Pakleni/kingslayer-28-custom-gaming-keypad/README.md

# Kingslayer 28
*Fully custom 28 key gaming keypad*

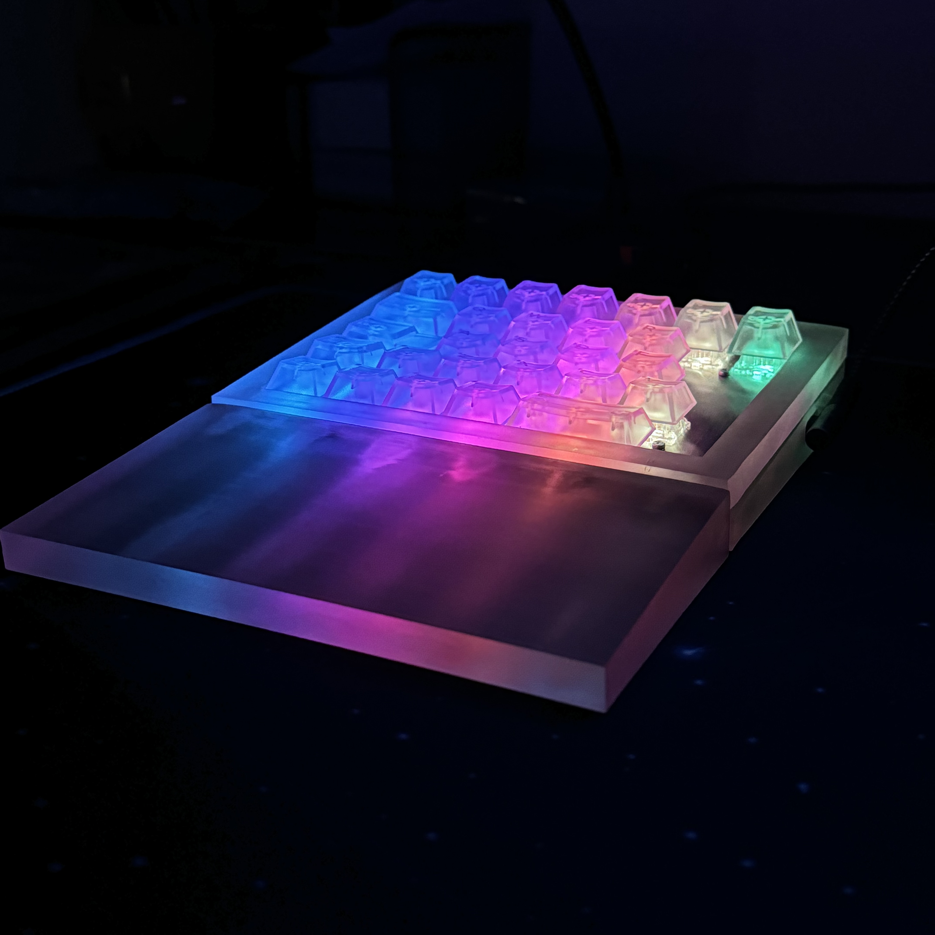
[picture p1: keyboard.jpeg]


## Images

### Keyboard Layout
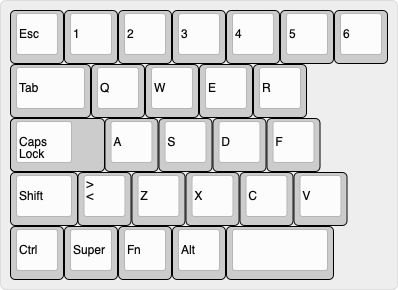
[picture p2: keyboard-layout-editor/keyboard-layout.png]


### Plate
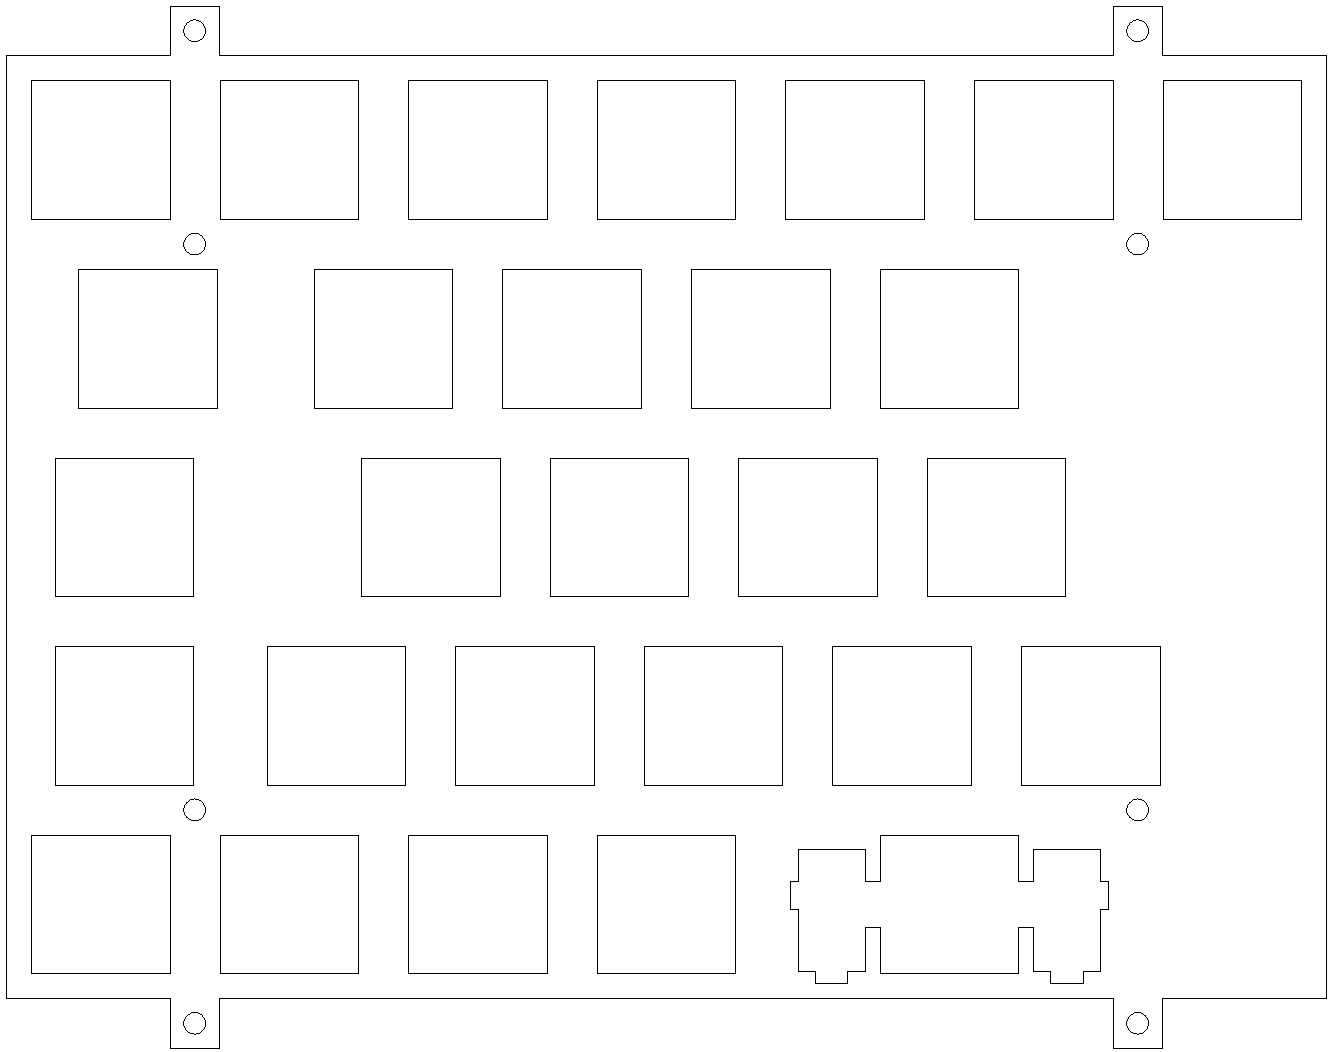
[picture p3: librecad/plate.png]


### PCB
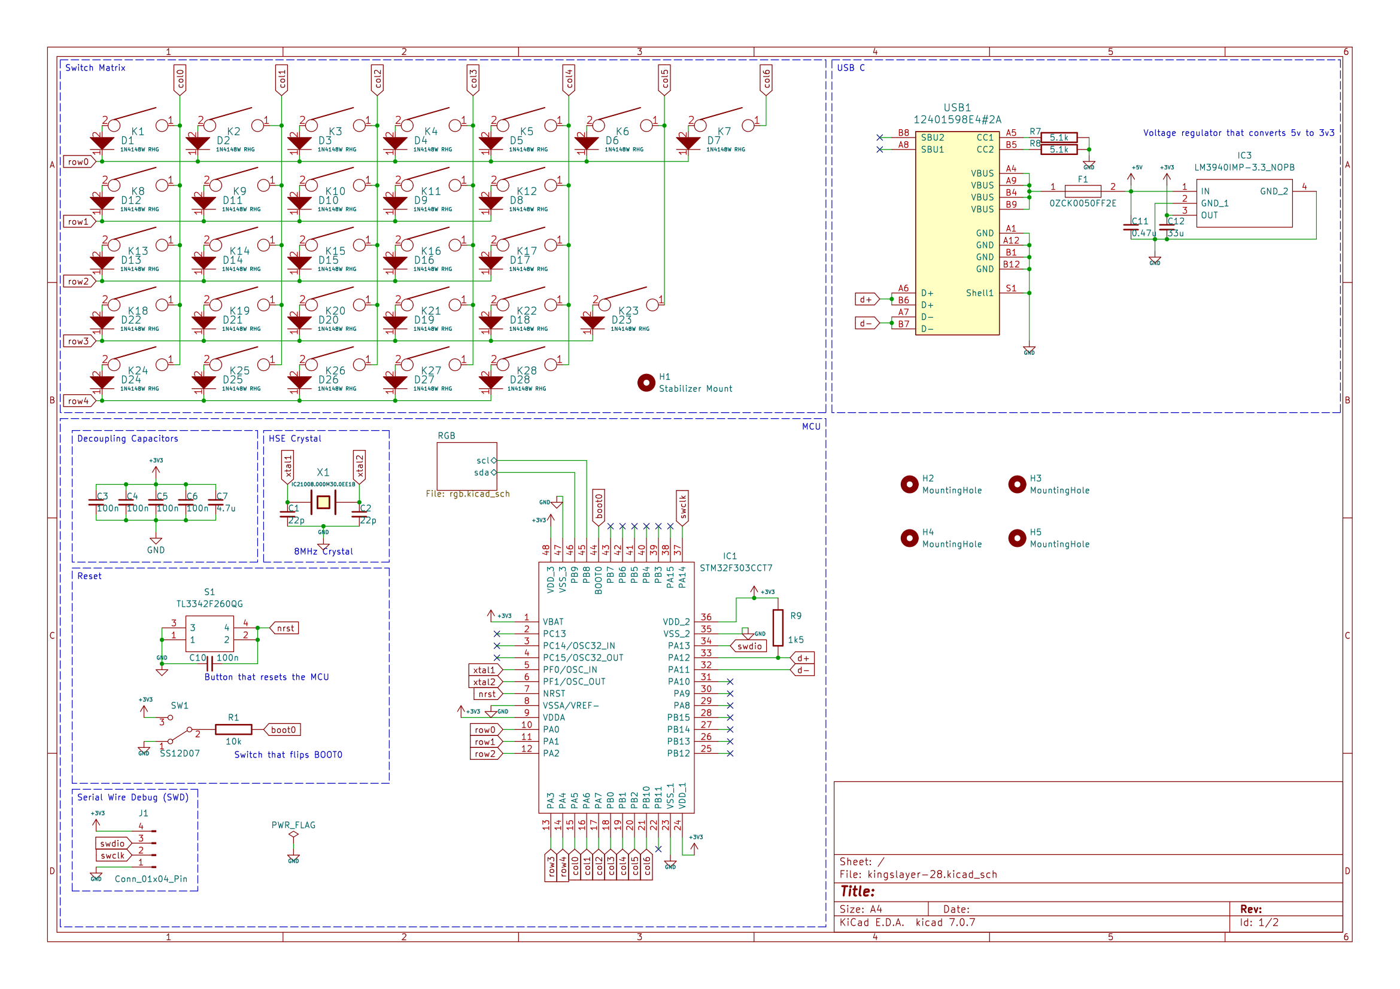
[picture p4: kicad/kingslayer-28-1.png]

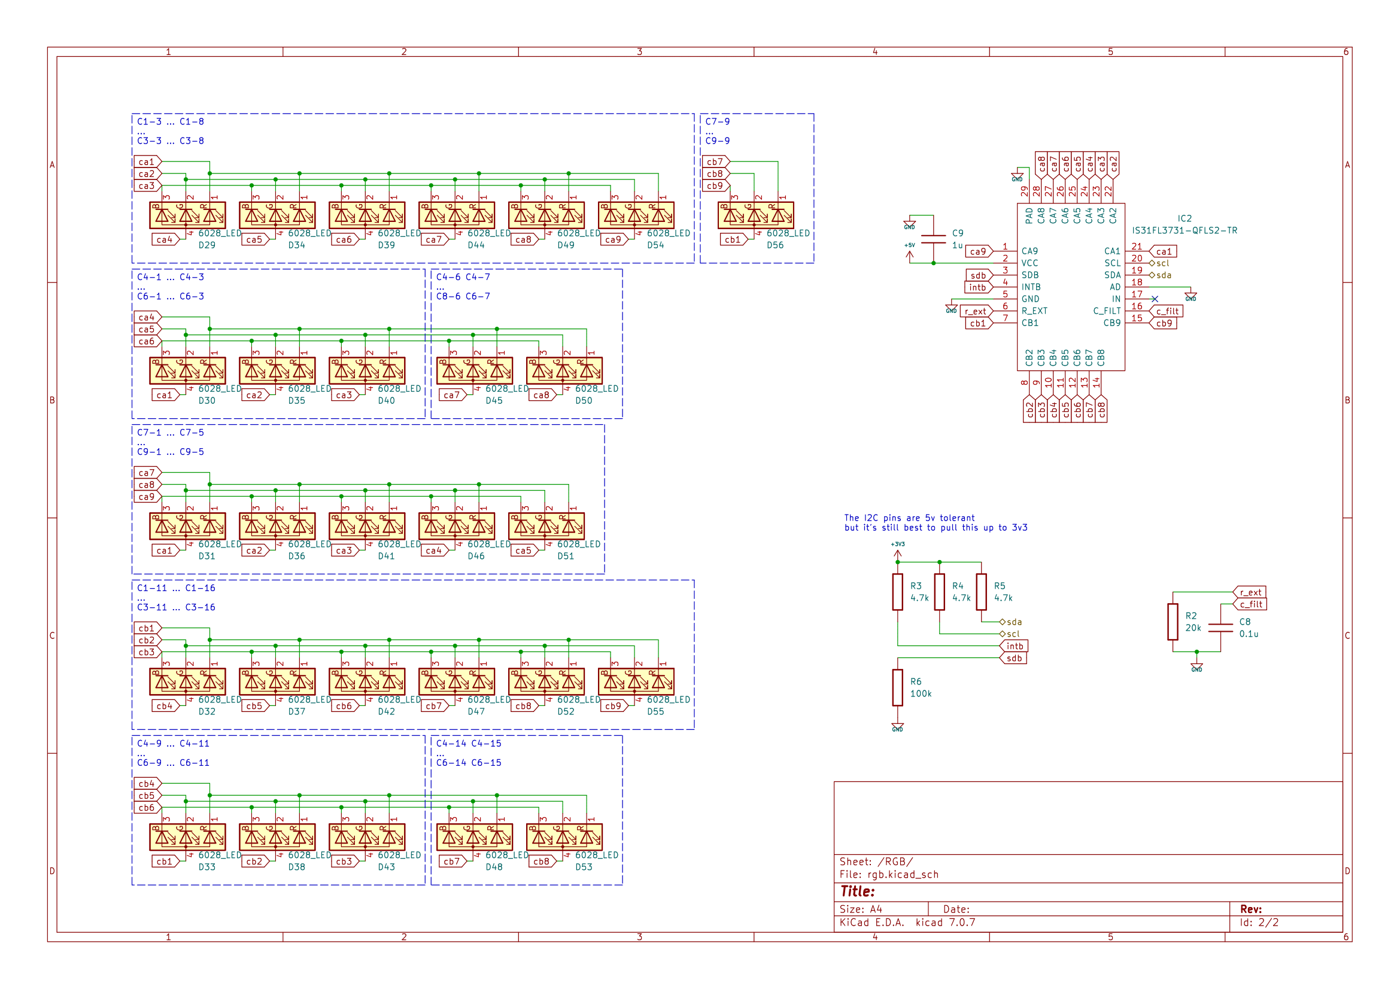
[picture p5: kicad/kingslayer-28-2.png]

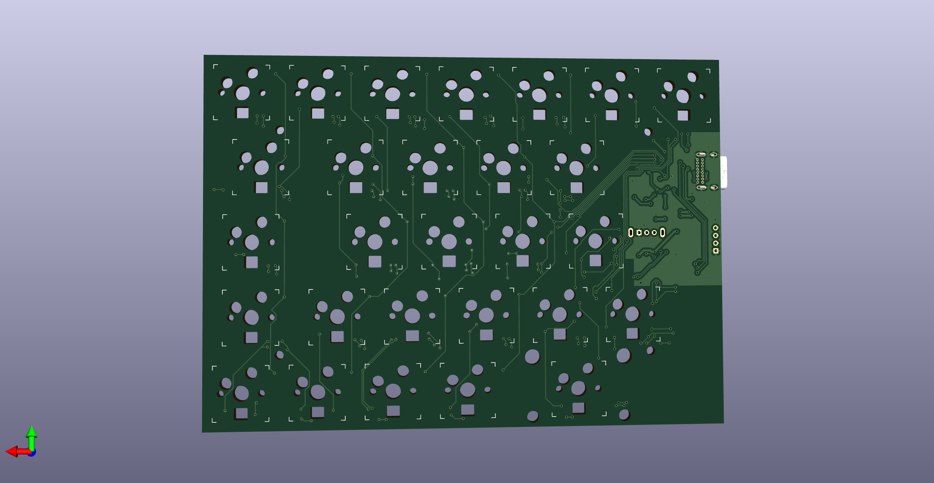
[picture p6: kicad/kingslayer-28-front.png]

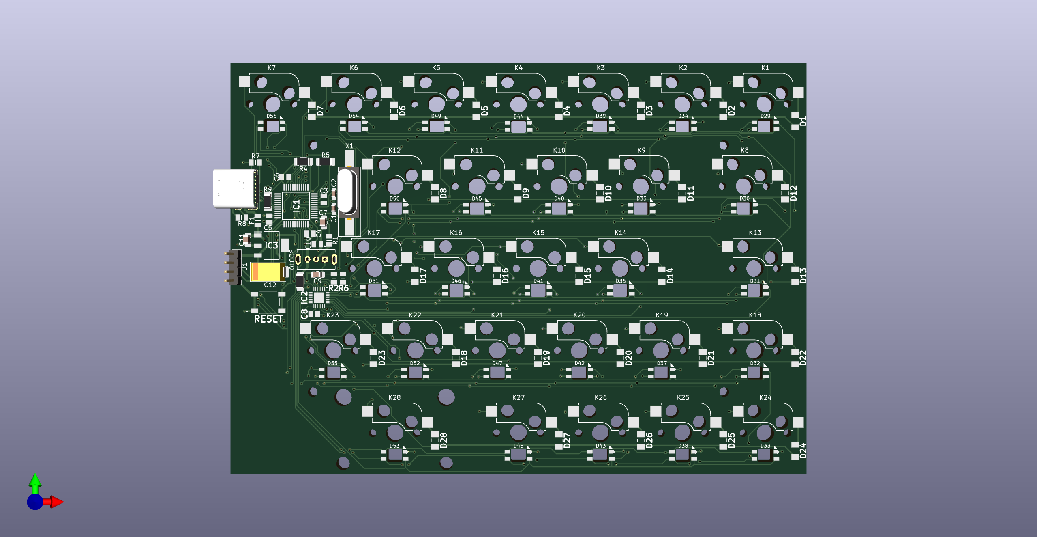
[picture p7: kicad/kingslayer-28-back.png]


## Features
* Per-Key RGB
* South Facing LED
* Hot-Swap Sockets
* Custom Plate
* USB-C
* 5-pin Sockets
* Plate Mount & PCB Screw-in Stabilizer support
* Top mount design
* QMK support
* Wrist Rest with magnetic attachment mechanism
* 5 degree positive tilt

## Used
* http://www.keyboard-layout-editor.com
* http://builder.swillkb.com
* https://librecad.org
* https://www.kicad.org
