Pakleni/kingslayer-28-custom-gaming-keypad/3dprinting/README.md

# Printing & Assembly Notes
* The .stl files are in cm, so you need to 10x them if printer reads it as mm.
* The BOOT switch stem will probably need trimming in order for everything to fit.
