Pakleni/kingslayer-28-custom-gaming-keypad/plate-drawing.jpg

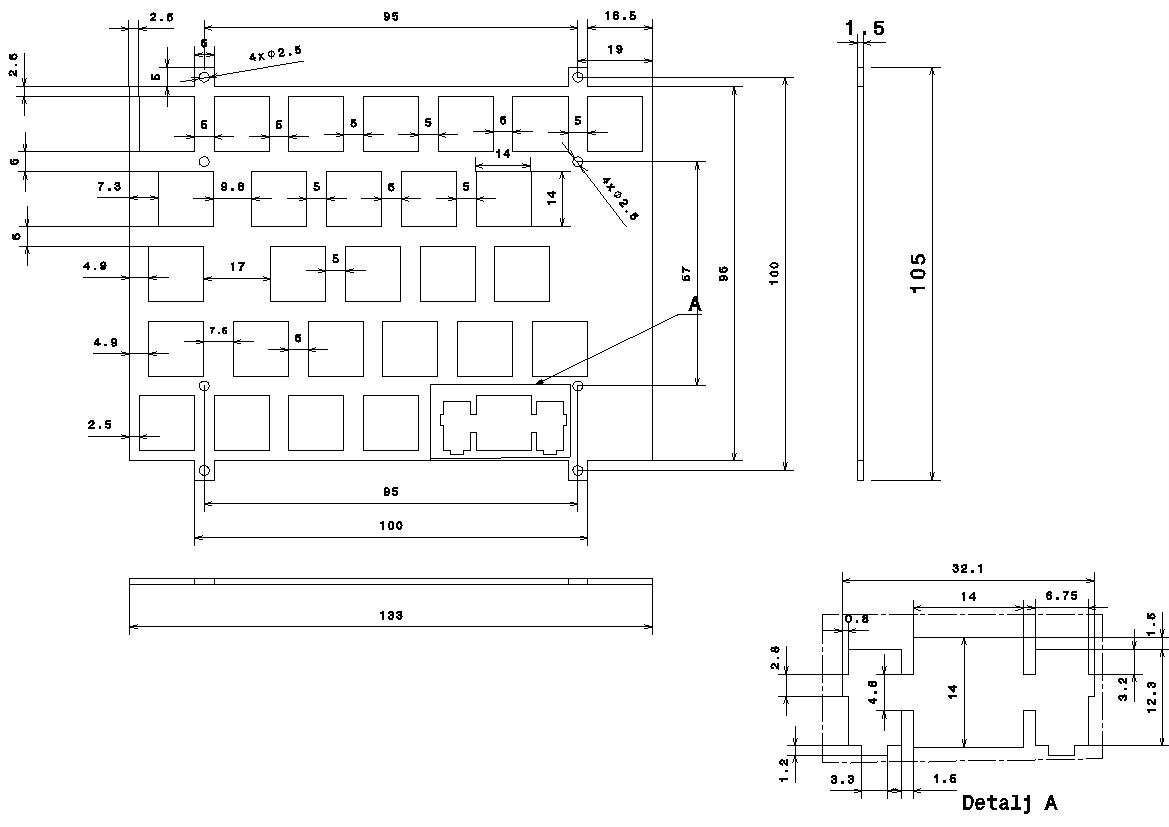
plate-drawing.jpg
