Pakleni/kingslayer-28-custom-gaming-keypad/3dprinting/spacer.stl

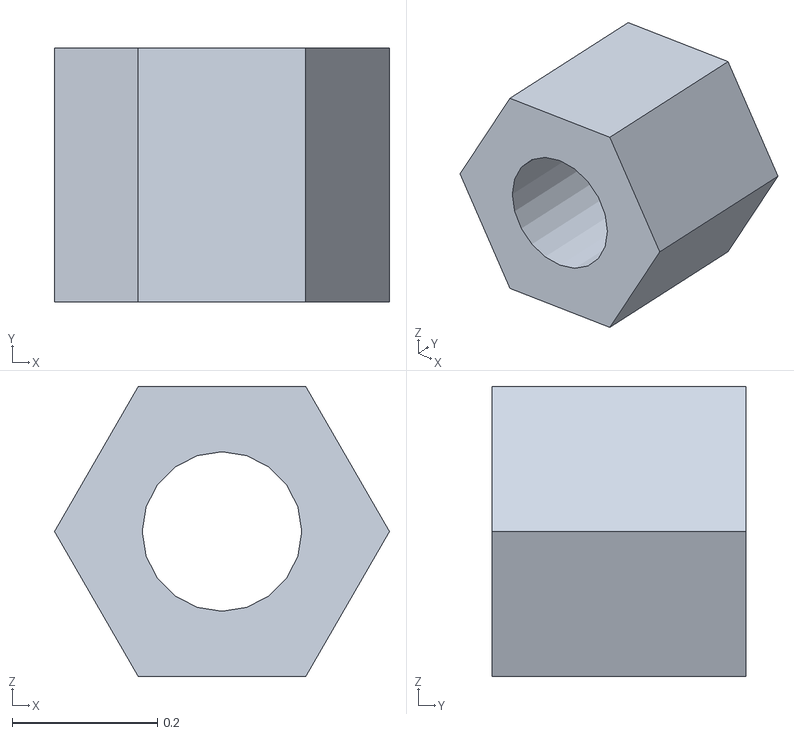
[picture p9: CAD file, 2024-06-16]
3dprinting/spacer.stl
0.462 x 0.35 x 0.4
