Pakleni/kingslayer-28-custom-gaming-keypad/kicad/kingslayer-28/3dmodels/0ZCK0050FF2E.stp

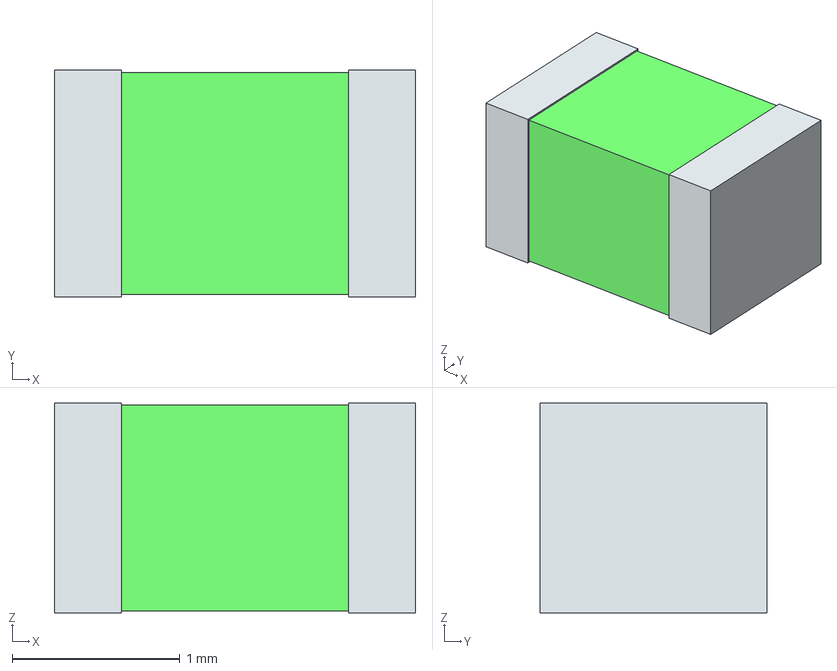
[picture p10: CAD file, 2023-10-20]
kicad/kingslayer-28/3dmodels/0ZCK0050FF2E.stp
2.15 x 1.35 x 1.25 mm
term1
term2
