Pakleni/kingslayer-28-custom-gaming-keypad/librecad/plate.dxf

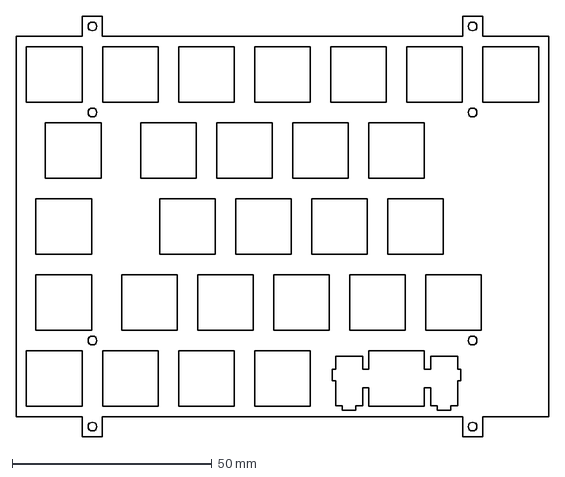
[picture p11: CAD file, 2023-09-16]
librecad/plate.dxf
133.3 x 105.2 mm
