Pakleni/kingslayer-28-custom-gaming-keypad/3dprinting/case-top.stl

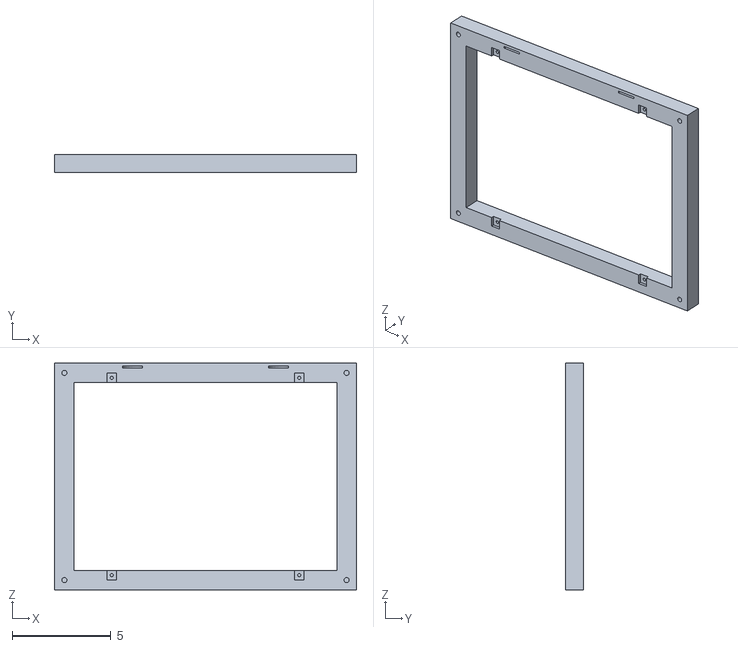
[picture p12: CAD file, 2024-01-22]
3dprinting/case-top.stl
15.3 x 0.9 x 11.5
