Pakleni/kingslayer-28-custom-gaming-keypad/kicad/kingslayer-28/3dmodels/RMCF0805JT100K.stp

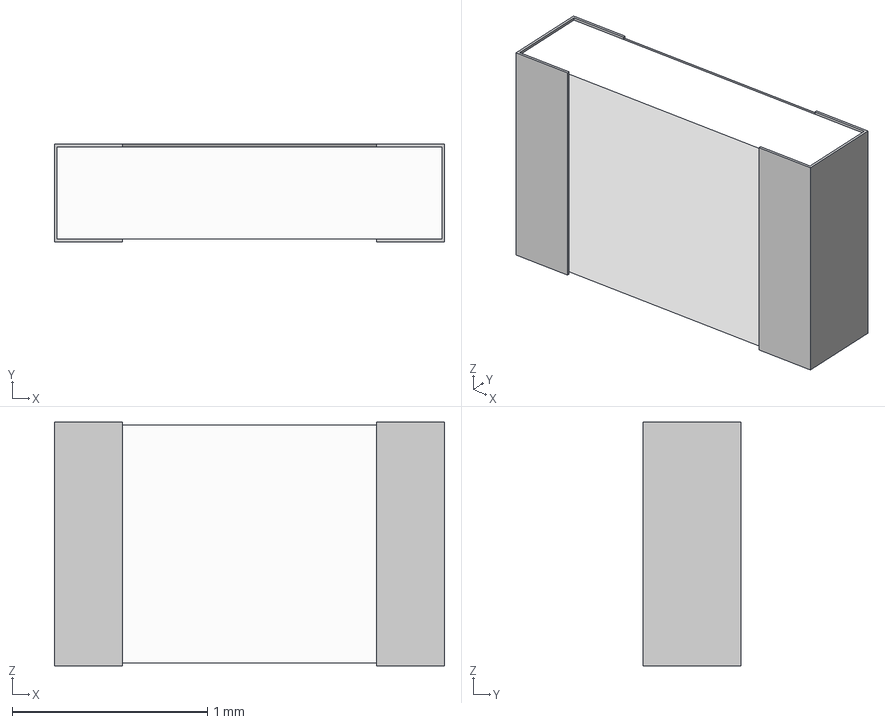
[picture p13: CAD file, 2023-10-19]
kicad/kingslayer-28/3dmodels/RMCF0805JT100K.stp
2.00 x 0.5 x 1.25 mm
