Pakleni/kingslayer-28-custom-gaming-keypad/librecad/case-top.dxf

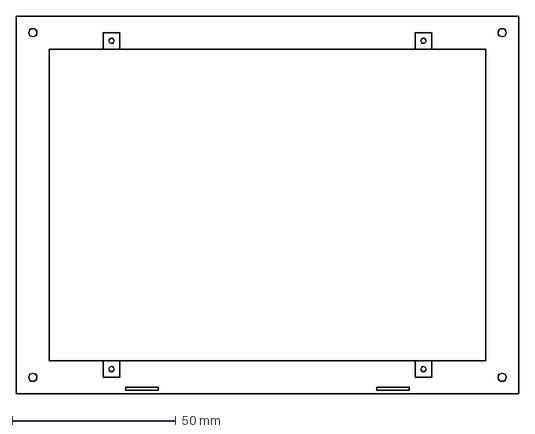
[picture p14: CAD file, 2023-09-16]
librecad/case-top.dxf
153.4 x 115.2 mm
