Pakleni/kingslayer-28-custom-gaming-keypad/3dprinting/case-bottom.stl

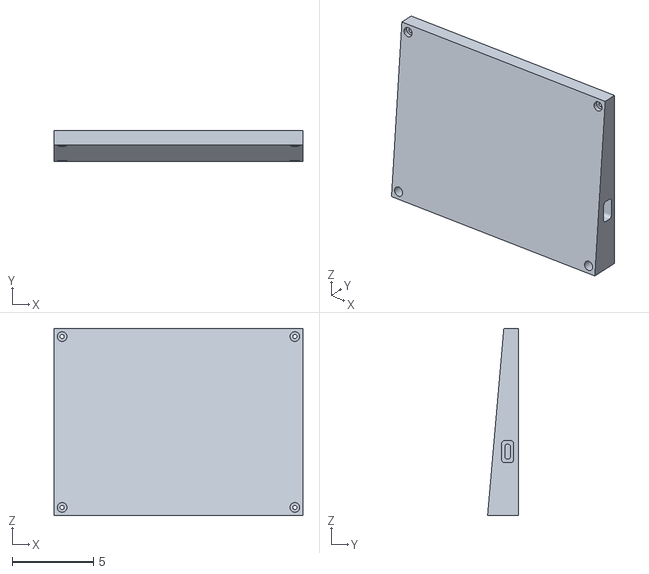
[picture p15: CAD file, 2024-01-06]
3dprinting/case-bottom.stl
15.3 x 1.90 x 11.5
