Pakleni/kingslayer-28-custom-gaming-keypad/librecad/case-side.dxf

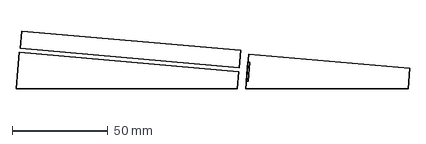
[picture p16: CAD file, 2023-09-16]
librecad/case-side.dxf
205.9 x 30.0 mm
