Pakleni/kingslayer-28-custom-gaming-keypad/3dprinting/wrist-rest.stl

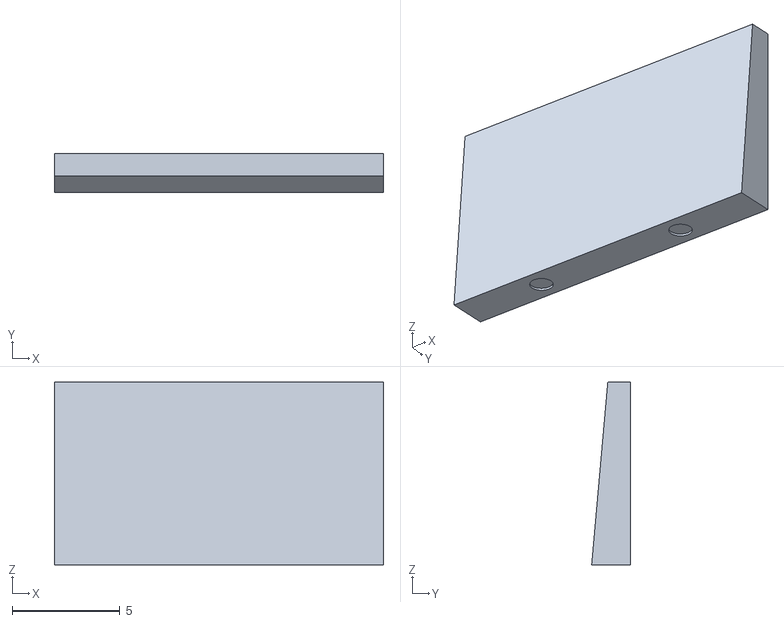
[picture p17: CAD file, 2024-01-06]
3dprinting/wrist-rest.stl
15.3 x 1.80 x 8.50
