Pakleni/kingslayer-28-custom-gaming-keypad/librecad/case-bottom.dxf

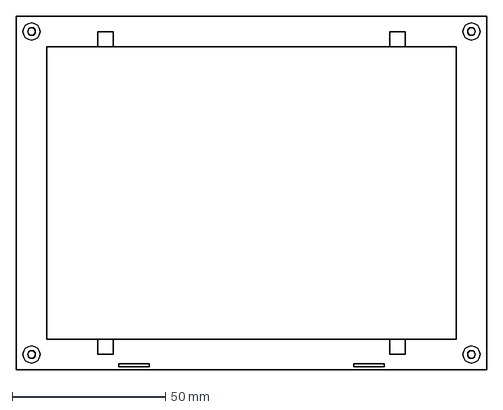
[picture p18: CAD file, 2023-09-16]
librecad/case-bottom.dxf
153.4 x 115.2 mm
