Pakleni/kingslayer-28-custom-gaming-keypad/kicad/kingslayer-28/3dmodels/SS12D07VG4--3DModel-STEP-510211.STEP

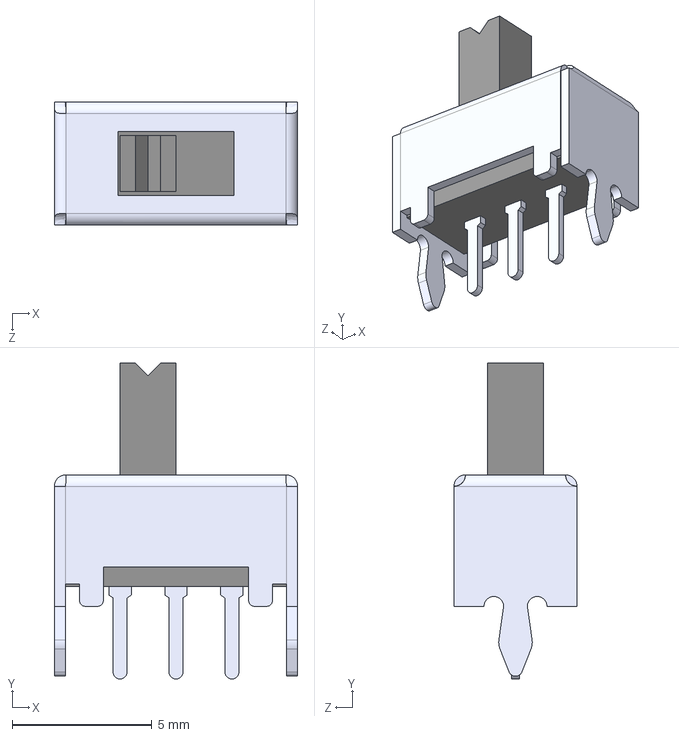
[picture p19: CAD file, 2023-10-12]
kicad/kingslayer-28/3dmodels/SS12D07VG4--3DModel-STEP-510211.STEP
8.70 x 11.3 x 4.40 mm
