Pakleni/kingslayer-28-custom-gaming-keypad/kicad/kingslayer-28/3dmodels/08053C104KAT2A.stp

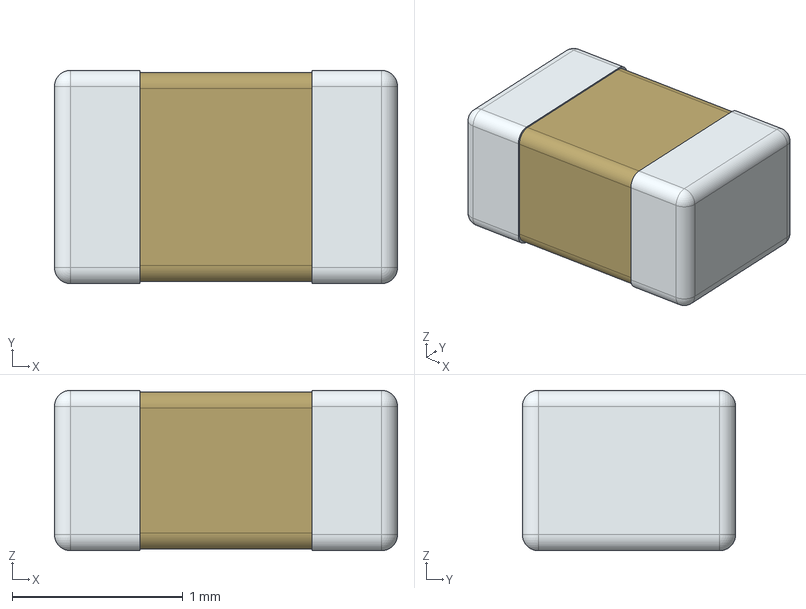
[picture p20: CAD file, 2023-10-19]
kicad/kingslayer-28/3dmodels/08053C104KAT2A.stp
2.01 x 1.25 x 0.94 mm
