Pakleni/kingslayer-28-custom-gaming-keypad/kicad/kingslayer-28/kingslayer-28.kicad_pcb

## KiCad design kicad/kingslayer-28/kingslayer-28.kicad_pcb (2024-02-18)

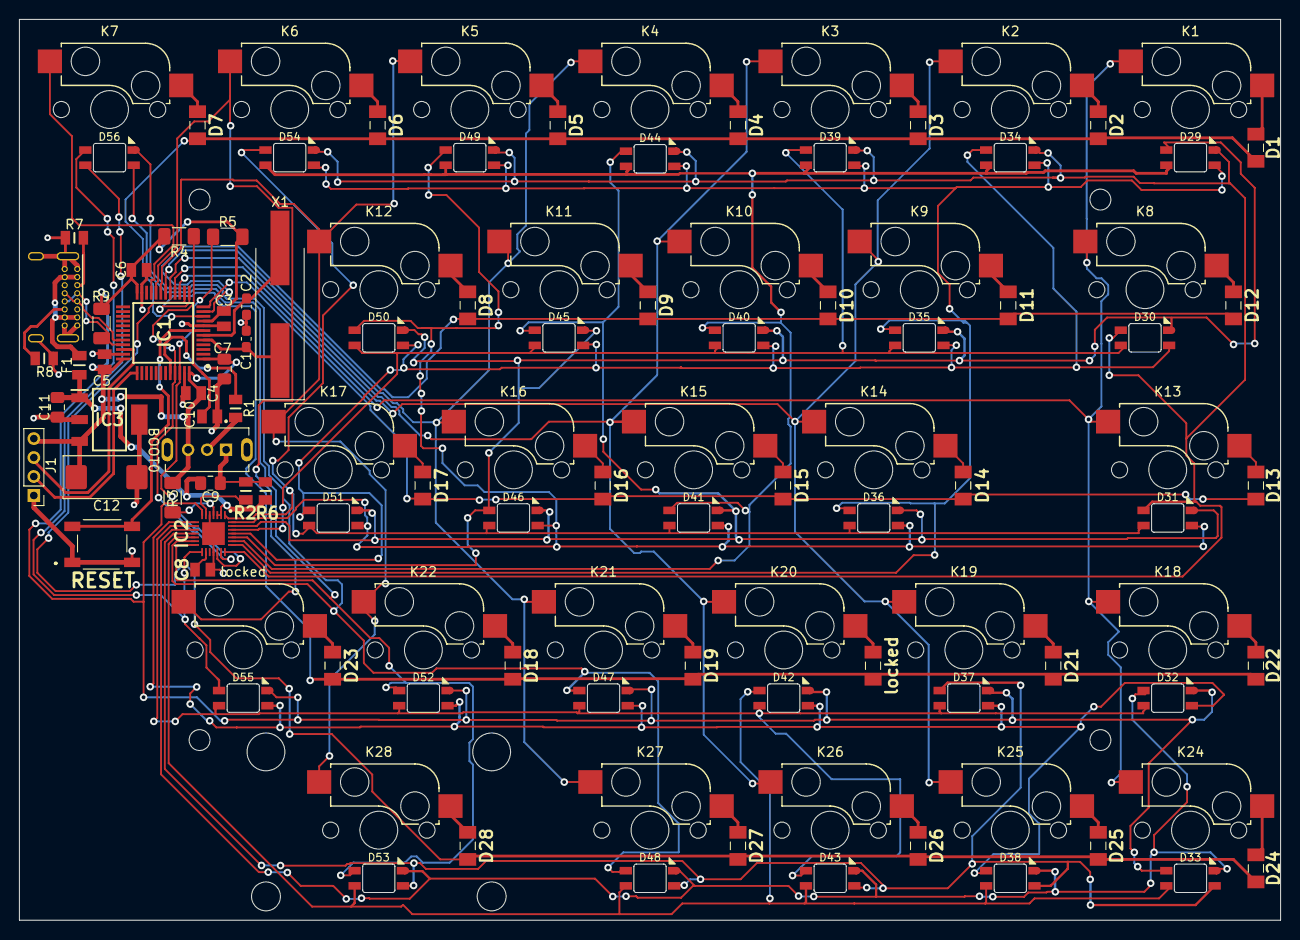
[picture p21: board kingslayer-28.kicad_pcb from above]

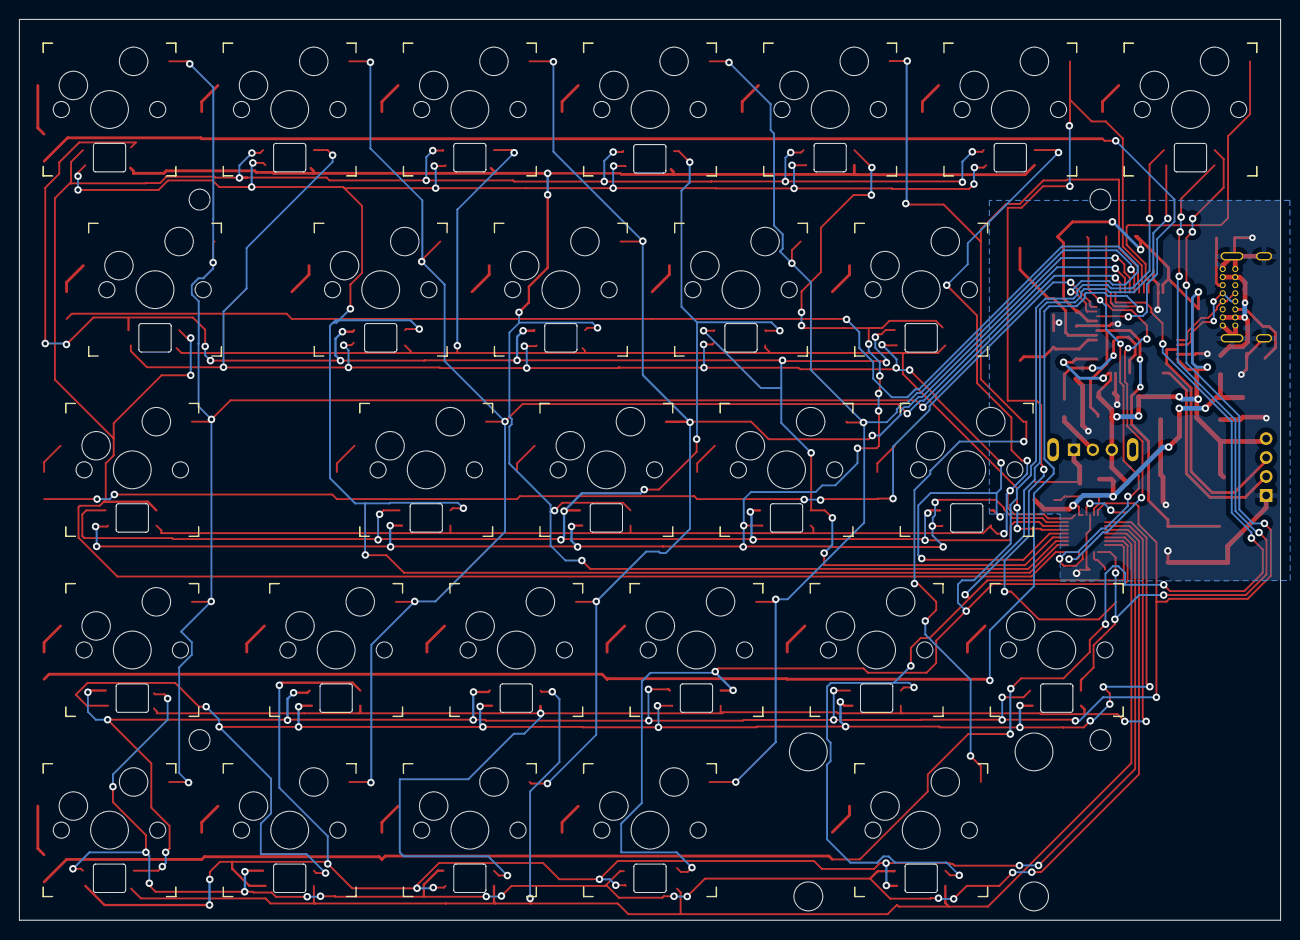
[picture p22: board kingslayer-28.kicad_pcb from below]

Board: 2 copper layers, 133.0 x 95.0 mm, 119 parts (33 on the bottom side), 78 nets.

Parts:
C1, C2: 22p; C_0603_1608Metric_Pad1.08x0.95mm_HandSolder
C3, C4, C5, C6, C10: 100n; CAPC2012X94N
C7: 4.7u; C_0805_2012Metric_Pad1.18x1.45mm_HandSolder
C8: 0.1u; CAPC2012X94N
C9: 1u; C_0805_2012Metric_Pad1.18x1.45mm_HandSolder
C11: 0.47u; C_0805_2012Metric_Pad1.18x1.45mm_HandSolder
C12: 33u; CP_EIA-7343-31_Kemet-D_Pad2.25x2.55mm_HandSolder
D1, D2, D3, D4, D5, D6, D7, D8, D9, D10, D11, D12, D13, D14, D15, D16, D17, D18, D19, D21, D22, D23, D24, D25, D26, D27, D28: 1N4148W RHG; 1N4148WRHG
D29, D30, D31, D32, D33, D34, D35, D36, D37, D38, D39, D40, D41, D42, D43, D44, D45, D46, D47, D48, D49, D50, D51, D52, D53, D54, D55, D56: 6028_LED; LED_RGB_SMD_6028_2.8x3.5mm_Square
F1: 0ZCK0050FF2E; FUSC2214X125N
H1: Stabilizer Mount; Stabilizer_MX_2u
H2, H3, H4, H5: MountingHole; MountingHole_2.2mm_M2_ISO7380
IC1: STM32F303CCT7; QFP50P900X900X160-48N
IC2: IS31FL3731-QFLS2-TR; QFN40P400X400X80-29N
IC3: LM3940IMP-3.3_NOPB; SOT230P700X180-4N
J1: Conn_01x04_Pin; PinHeader_1x04_P2.00mm_Vertical
K1, K2, K3, K4, K5, K6, K7, K8, K9, K10, K11, K12, K13, K14, K15, K16, K17, K18, K19, K20, K21, K22, K24, K25, K26, K27, K28: KEYSW; Kailh_socket_MX
R1: 10k; RESC2012X65N
R2: 20k; RESC2012X60N
R3, R4, R5: 4.7k; R_1206_3216Metric_Pad1.30x1.75mm_HandSolder
R6: 100k; RESC2012X65N
R7, R8: 5.1k; RESC2012X60N
R9: 1k5; R_1206_3216Metric_Pad1.30x1.75mm_HandSolder
S1: TL3342F260QG
SW1: SS12D07; SW_SS12D07VG4
USB1: 12401598E4#2A; USB_C_GCT_USB4085
X1: IC21008.000M30.0EE1B; Crystal_SMD_HC49-SD_HandSoldering
locked: 1N4148W RHG; 1N4148WRHG
locked#2: KEYSW; Kailh_socket_MX

Connections:
+3V3: C3.1, C4.1, C5.1, C6.1, C7.1, C12.1, IC1.1 (VBAT), IC1.9 (VDDA), IC1.24 (VDD_1), IC1.36 (VDD_2), IC1.48 (VDD_3), IC3.3 (OUT), J1.4, R3.1, R4.1, R5.1, R9.1, SW1.3 (C)
+5V: C9.1, C11.1, F1.2, IC2.2 (VCC), IC2.3 (SDB), IC3.1 (IN), R6.1
/RGB/scl: IC1.45 (PB8), IC2.20 (SCL), R4.2
/RGB/sda: IC1.46 (PB9), IC2.19 (SDA), R5.2
GND: C1.2, C2.2, C3.2, C4.2, C5.2, C6.2, C7.2, C8.2, C9.2, C10.1, C11.2, C12.2, IC1.8 (VSSA/VREF-), IC1.23 (VSS_1), IC1.35 (VSS_2), IC1.47 (VSS_3), IC2.5 (GND), IC2.18 (AD), IC2.29 (PAD), IC3.2 (GND_1), IC3.4 (GND_2), J1.1, R2.2, R6.2, R7.2, R8.2, S1.1, S1.2, SW1.1 (A), USB1.A1 (GND), USB1.A12 (GND), USB1.B1 (GND), USB1.B12 (GND), USB1.S1 (Shell1)
unnamed: D1.2, K1.2
unnamed: D2.2, K2.2
unnamed: D3.2, K3.2
unnamed: D4.2, K4.2
unnamed: D5.2, K5.2
unnamed: D6.2, K6.2
unnamed: D7.2, K7.2
unnamed: D8.2, K12.2
unnamed: D9.2, K11.2
unnamed: D10.2, K10.2
unnamed: D11.2, K9.2
unnamed: D12.2, K8.2
unnamed: D13.2, K13.2
unnamed: D14.2, K14.2
unnamed: D15.2, K15.2
unnamed: D16.2, K16.2
unnamed: D17.2, K17.2
unnamed: D18.2, K22.2
unnamed: D19.2, K21.2
unnamed: K20.2, locked.2
unnamed: D21.2, K19.2
unnamed: D22.2, K18.2
unnamed: D23.2, locked#2.2
unnamed: D24.2, K24.2
unnamed: D25.2, K25.2
unnamed: D26.2, K26.2
unnamed: D27.2, K27.2
unnamed: D28.2, K28.2
unnamed: F1.1, USB1.A4 (VBUS), USB1.A9 (VBUS), USB1.B4 (VBUS), USB1.B9 (VBUS)
unnamed: R1.1, SW1.2 (B)
unnamed: R7.1, USB1.A5 (CC1)
unnamed: R8.1, USB1.B5 (CC2)
boot0: IC1.44 (BOOT0), R1.2
c_filt: C8.1, IC2.16 (C_FILT)
ca1: D29.4 (RK), D30.2 (A), D31.2 (A), D34.4 (RK), D39.4 (RK), D44.4 (RK), D49.4 (RK), D54.4 (RK), IC2.21 (CA1)
ca2: D29.3 (GK), D34.3 (GK), D35.2 (A), D36.2 (A), D39.3 (GK), D44.3 (GK), D49.3 (GK), D54.3 (GK), IC2.22 (CA2)
ca3: D29.1 (BK), D34.1 (BK), D39.1 (BK), D40.2 (A), D41.2 (A), D44.1 (BK), D49.1 (BK), D54.1 (BK), IC2.23 (CA3)
ca4: D29.2 (A), D30.4 (RK), D35.4 (RK), D40.4 (RK), D45.4 (RK), D46.2 (A), D50.4 (RK), IC2.24 (CA4)
ca5: D30.3 (GK), D34.2 (A), D35.3 (GK), D40.3 (GK), D45.3 (GK), D50.3 (GK), D51.2 (A), IC2.25 (CA5)
ca6: D30.1 (BK), D35.1 (BK), D39.2 (A), D40.1 (BK), D45.1 (BK), D50.1 (BK), IC2.26 (CA6)
ca7: D31.4 (RK), D36.4 (RK), D41.4 (RK), D44.2 (A), D45.2 (A), D46.4 (RK), D51.4 (RK), IC2.27 (CA7)
ca8: D31.3 (GK), D36.3 (GK), D41.3 (GK), D46.3 (GK), D49.2 (A), D50.2 (A), D51.3 (GK), IC2.28 (CA8)
ca9: D31.1 (BK), D36.1 (BK), D41.1 (BK), D46.1 (BK), D51.1 (BK), D54.2 (A), IC2.1 (CA9)
cb1: D32.4 (RK), D33.2 (A), D37.4 (RK), D42.4 (RK), D47.4 (RK), D52.4 (RK), D55.4 (RK), D56.2 (A), IC2.7 (CB1)
cb2: D32.3 (GK), D37.3 (GK), D38.2 (A), D42.3 (GK), D47.3 (GK), D52.3 (GK), D55.3 (GK), IC2.8 (CB2)
cb3: D32.1 (BK), D37.1 (BK), D42.1 (BK), D43.2 (A), D47.1 (BK), D52.1 (BK), D55.1 (BK), IC2.9 (CB3)
cb4: D32.2 (A), D33.4 (RK), D38.4 (RK), D43.4 (RK), D48.4 (RK), D53.4 (RK), IC2.10 (CB4)
cb5: D33.3 (GK), D37.2 (A), D38.3 (GK), D43.3 (GK), D48.3 (GK), D53.3 (GK), IC2.11 (CB5)
cb6: D33.1 (BK), D38.1 (BK), D42.2 (A), D43.1 (BK), D48.1 (BK), D53.1 (BK), IC2.12 (CB6)
cb7: D47.2 (A), D48.2 (A), D56.4 (RK), IC2.13 (CB7)
cb8: D52.2 (A), D53.2 (A), D56.3 (GK), IC2.14 (CB8)
cb9: D55.2 (A), D56.1 (BK), IC2.15 (CB9)
col0: IC1.15 (PA5), K1.1, K8.1, K13.1, K18.1, K24.1
col1: IC1.16 (PA6), K2.1, K9.1, K14.1, K19.1, K25.1
col2: IC1.17 (PA7), K3.1, K10.1, K15.1, K20.1, K26.1
col3: IC1.18 (PB0), K4.1, K11.1, K16.1, K21.1, K27.1
col4: IC1.19 (PB1), K5.1, K12.1, K17.1, K22.1, K28.1
col5: IC1.20 (PB2), K6.1, locked#2.1
col6: IC1.21 (PB10), K7.1
d+: IC1.33 (PA12), R9.2, USB1.A6 (D+), USB1.B6 (D+)
d-: IC1.32 (PA11), USB1.A7 (D-), USB1.B7 (D-)
intb: IC2.4 (INTB), R3.2
nrst: C10.2, IC1.7 (NRST), S1.3, S1.4
r_ext: IC2.6 (R_EXT), R2.1
row0: D1.1, D2.1, D3.1, D4.1, D5.1, D6.1, D7.1, IC1.10 (PA0)
row1: D8.1, D9.1, D10.1, D11.1, D12.1, IC1.11 (PA1)
row2: D13.1, D14.1, D15.1, D16.1, D17.1, IC1.12 (PA2)
row3: D18.1, D19.1, D21.1, D22.1, D23.1, IC1.13 (PA3), locked.1
row4: D24.1, D25.1, D26.1, D27.1, D28.1, IC1.14 (PA4)
swclk: IC1.37 (PA14), J1.2
swdio: IC1.34 (PA13), J1.3
xtal1: C1.1, IC1.5 (PF0/OSC_IN), X1.1
xtal2: C2.1, IC1.6 (PF1/OSC_OUT), X1.2
