Pakleni/kingslayer-28-custom-gaming-keypad/(commit log)

2023-09-16 add images
    [plate.dxf]
2023-09-26 Day 1
    [kingslayer-28.kicad_sch]
2023-09-26 Setting up microcontroller
    [kingslayer-28.kicad_sch]
2023-09-27 Add RGB controller
    [kingslayer-28.kicad_sch]
2023-09-27 tidy up the schematic
    [kingslayer-28.kicad_sch]
2023-09-27 add RGB matrix
    [kingslayer-28.kicad_sch]
2023-09-27 RGB matrix 2
    [kingslayer-28.kicad_sch]
2023-09-28 USB C
    [kingslayer-28.kicad_sch, rgb.kicad_sch]
2023-09-28 connect rgb
    [kingslayer-28.kicad_sch, rgb.kicad_sch]
2023-10-01 MCU done...
    [kingslayer-28.kicad_sch]
2023-10-01 done I guess
    [kingslayer-28.kicad_sch]
2023-10-01 add info
    [kingslayer-28.kicad_sch, rgb.kicad_sch]
2023-10-01 add PCB images
2023-10-02 Addressed some comments
    [kingslayer-28.kicad_sch, rgb.kicad_sch]
2023-10-02 update pics
    [kingslayer-28.kicad_sch, rgb.kicad_sch]
2023-10-05 Update after watching phil
    [kingslayer-28.kicad_sch]
2023-10-06 ground shield
    [kingslayer-28.kicad_sch]
2023-10-06 ERC check
    [kingslayer-28.kicad_sch, rgb.kicad_sch]
2023-10-12 assign some footprints
    [kingslayer-28.kicad_sch, rgb.kicad_sch]
2023-10-12 update mounting holes
    [kingslayer-28.kicad_sch]
2023-10-12 header, switch, oscillator
    [kingslayer-28.kicad_sch]
2023-10-19 footprint mapping
    [08053C104KAT2A.stp, RMCF0805JT100K.stp, RMCF0805JT10K0.stp, SS12D07VG4--3DModel-STEP-510211.STEP, kingslayer-28.kicad_sch, rgb.kicad_sch]
2023-10-20 Add fuse because of tantalum cap
    [0ZCK0050FF2E.stp, kingslayer-28.kicad_sch]
2023-12-10 finish footprint picking
    [kingslayer-28.kicad_pcb, kingslayer-28.kicad_sch, rgb.kicad_sch]
2023-12-10 placed switches, switch diodes and mounting holes
    [kingslayer-28.kicad_pcb]
2023-12-11 initial placement
    [kingslayer-28.kicad_pcb, kingslayer-28.kicad_sch, rgb.kicad_sch]
2023-12-11 swap mcu location
    [kingslayer-28.kicad_pcb]
2023-12-11 routing in progress
    [kingslayer-28.kicad_pcb]
2024-01-05 revert footprints, finalize placement
    [kingslayer-28.kicad_pcb, rgb.kicad_sch]
2024-01-06 finish routing?
    [kingslayer-28.kicad_pcb]
2024-01-06 added usb c 3d model
    [kingslayer-28.kicad_pcb]
2024-01-06 revert model change
    [kingslayer-28.kicad_pcb]
2024-01-06 3d model
    [kingslayer-28.kicad_pcb, kingslayer-28.kicad_sch]
2024-01-06 add 3d design
    [case-bottom.stl, case-top.stl, wrist-rest.stl]
2024-01-07 Started DRC
    [kingslayer-28.kicad_pcb]
2024-01-07 finish DRC
    [kingslayer-28-B_Cu.gbr, kingslayer-28-B_Mask.gbr, kingslayer-28-B_Paste.gbr, kingslayer-28-B_Silkscreen.gbr, kingslayer-28-Edge_Cuts.gbr, kingslayer-28-F_Cu.gbr, kingslayer-28-F_Mask.gbr, kingslayer-28-F_Paste.gbr]
2024-01-09 Add BOM
    [BOM.csv]
2024-01-22 update top
    [case-top.stl]
2024-02-11 found first error, need to redo pics and manufacturing
    [kingslayer-28.kicad_pcb, kingslayer-28.kicad_sch]
2024-02-12 ground loop
    [kingslayer-28.kicad_pcb]
2024-02-18 fix RGB
    [kingslayer-28.kicad_pcb, rgb.kicad_sch]
2024-02-18 generate new manufacturing files
    [kingslayer-28-B_Cu.gbr, kingslayer-28-B_Mask.gbr, kingslayer-28-B_Paste.gbr, kingslayer-28-B_Silkscreen.gbr, kingslayer-28-Edge_Cuts.gbr, kingslayer-28-F_Cu.gbr, kingslayer-28-F_Mask.gbr, kingslayer-28-F_Paste.gbr]
2024-06-09 add print
2024-06-16 new designs
    [case-bottom.stl, case-top.stl, spacer.stl, wrist-rest.stl]
2024-07-02 revert models
    [case-bottom.stl, case-top.stl, wrist-rest.stl]
